faryon93/vocore2-mb/README.md

# VoCore2 Motherboard

* 1x Ethernet Breakout
* 3x Mini-PCIe Slot (USB Connection via USB 2.0 Hub)
* MicroSD Card
* FTDI console UART
* Passive PoE or Phoenix-style connector for power
* Buzzer
* SPI Flash Breakout Header

## Board
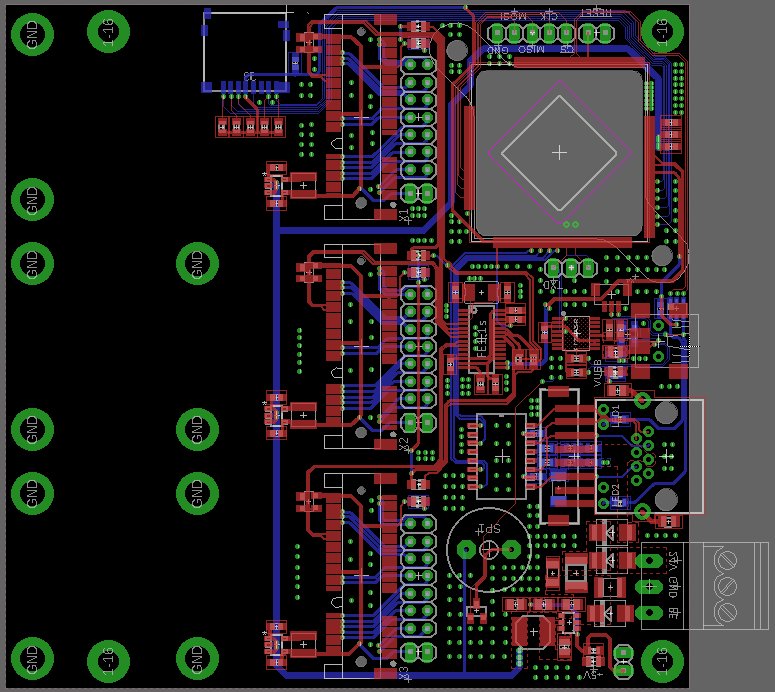
[picture p1: pcb-screenshot.PNG]
Screenshot PCB
