faryon93/vocore2-mb/vocore2-motherboard.brd

## EAGLE design vocore2-motherboard.brd (2019-12-21)

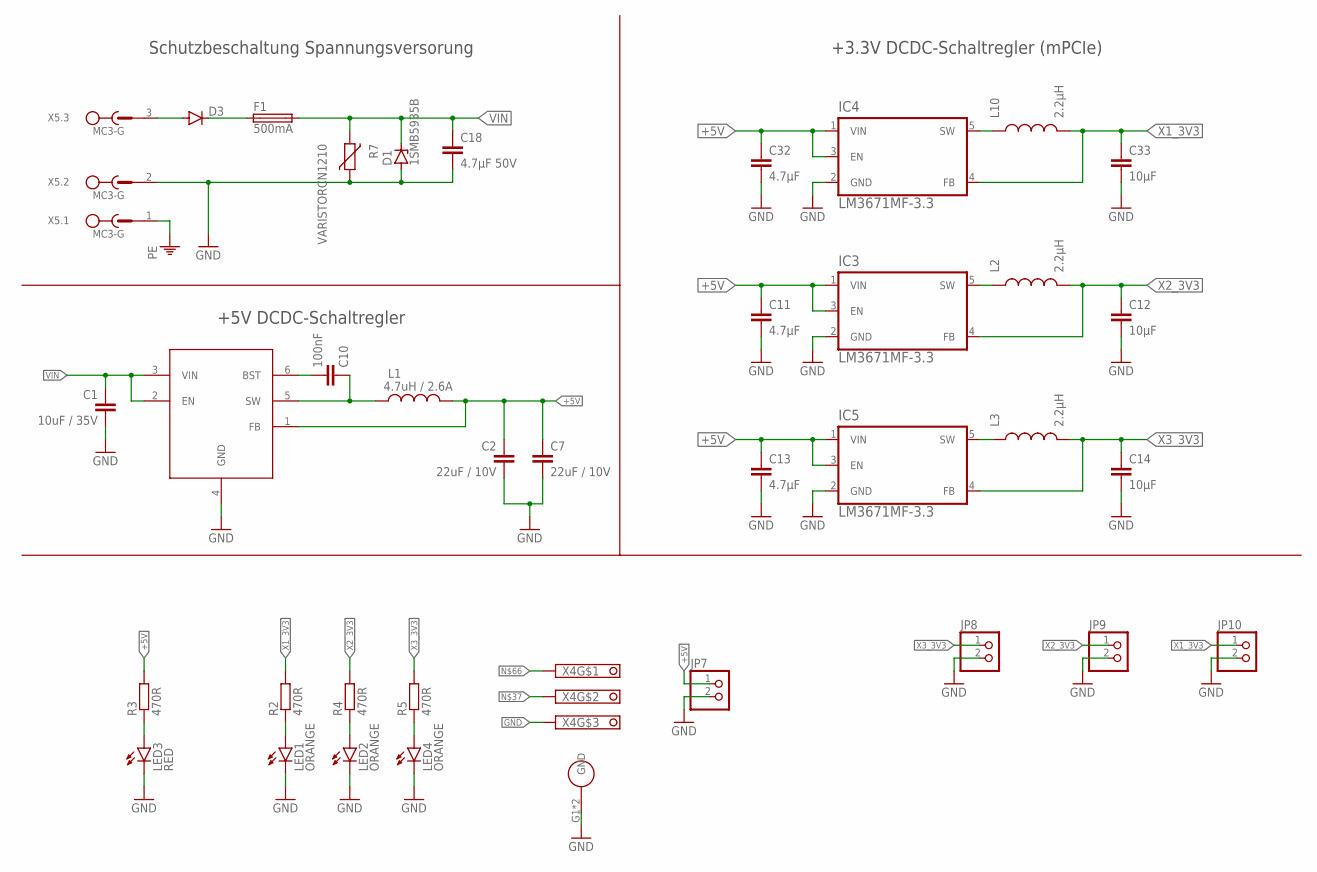
[picture p2: schematic vocore2-motherboard.sch, sheet 1, Power]

Parts:
C1: 10uF / 35V; C0805; DIGIKEY 490-13248-1-ND
C2, C7: 22uF / 10V; C0805; DIGIKEY 490-10511-1-ND
C10: 100nF; C0805
C11, C13, C32: 4.7µF; C0603; DIGIKEY 1276-2087-1-ND
C12, C14, C33: 10µF; C0603
C18: 4.7µF 50V; C1206; DIGIKEY 587-2994-1-ND
D1: 1SMB5935B; SMB; FARNELL 1431177
D3: DIODE-SMB; SMB; FARNELL 1858651
F1: 500mA; 1812; LCSC C17313
IC1: AP63205; SOT23-6
IC3, IC4, IC5: LM3671MF-3.3; SOT95P284X122-5N; DIGIKEY LM3671MF-3.3/NOPBCT-ND
JP7: PINHD-1X2_2.54; 1X02
JP8, JP9, JP10: PINHD-1X2; 1X02
L1: 4.7uH / 2.6A; 4.90X4.90; DIGIKEY 587-3605-2-ND
L2, L3, L10: 2.2µH; SO3314; DIGIKEY 445-8725-1-ND
LED1, LED2, LED4: ORANGE; CHIP-LED0805; DIGIKEY 160-1445-1-ND
LED3: RED; CHIP-LED0805; DIGIKEY 160-1447-1-ND
R2, R3, R4, R5: 470R; R0603
R7: VARISTORCN1210; CT/CN1210; FARNELL 1636457
X4: BM03B-SRSS-TB
X5: MC3-G; DIGIKEY ‎277-1207-ND‎;‎277-13872-ND‎

Connections:
+5V: C2.1, C7.1, C11.1, C13.1, C32.1, IC1.1 (FB), IC3.1 (VIN), IC3.3 (EN), IC4.1 (VIN), IC4.3 (EN), IC5.1 (VIN), IC5.3 (EN), JP7.1, L1.P$2 (2), R3.2; also elsewhere on the board
+24V: D3.C, F1.1; also elsewhere on the board
GND: C1.2, C2.2, C7.2, C11.2, C12.2, C13.2, C14.2, C18.2, C32.2, C33.2, D1.A, IC1.4 (GND), IC3.2 (GND), IC4.2 (GND), IC5.2 (GND), JP7.2, JP8.2, JP9.2, JP10.2, LED1.C, LED2.C, LED3.C, LED4.C, R7.1, X4.3 (K), X4.G1 (GND), X4.G2 (GND), X5.2; also elsewhere on the board
unnamed: C10.1, IC1.5 (SW), L1.P$1 (1)
unnamed: IC3.5 (SW), L2.1
unnamed: IC5.5 (SW), L3.1
unnamed: LED3.A, R3.1
unnamed: LED1.A, R2.1
unnamed: LED2.A, R4.1
unnamed: LED4.A, R5.1
unnamed 43: X4.2 (K); also elsewhere on the board
unnamed: IC4.5 (SW), L10.1
unnamed: D3.A, X5.3
unnamed: C10.2, IC1.6 (BST)
unnamed 65: X4.1 (K); also elsewhere on the board
PE: X5.1
VIN: C1.1, C18.1, D1.C, F1.2, IC1.2 (EN), IC1.3 (VIN), R7.2
X1_3V3: C33.1, IC4.4 (FB), JP10.1, L10.2, R2.2; also elsewhere on the board
X2_3V3: C12.1, IC3.4 (FB), JP9.1, L2.2, R4.2; also elsewhere on the board
X3_3V3: C14.1, IC5.4 (FB), JP8.1, L3.2, R5.2; also elsewhere on the board

Notes on the sheet:
Schutzbeschaltung Spannungsversorung
+5V DCDC-Schaltregler
+3.3V DCDC-Schaltregler (mPCIe)

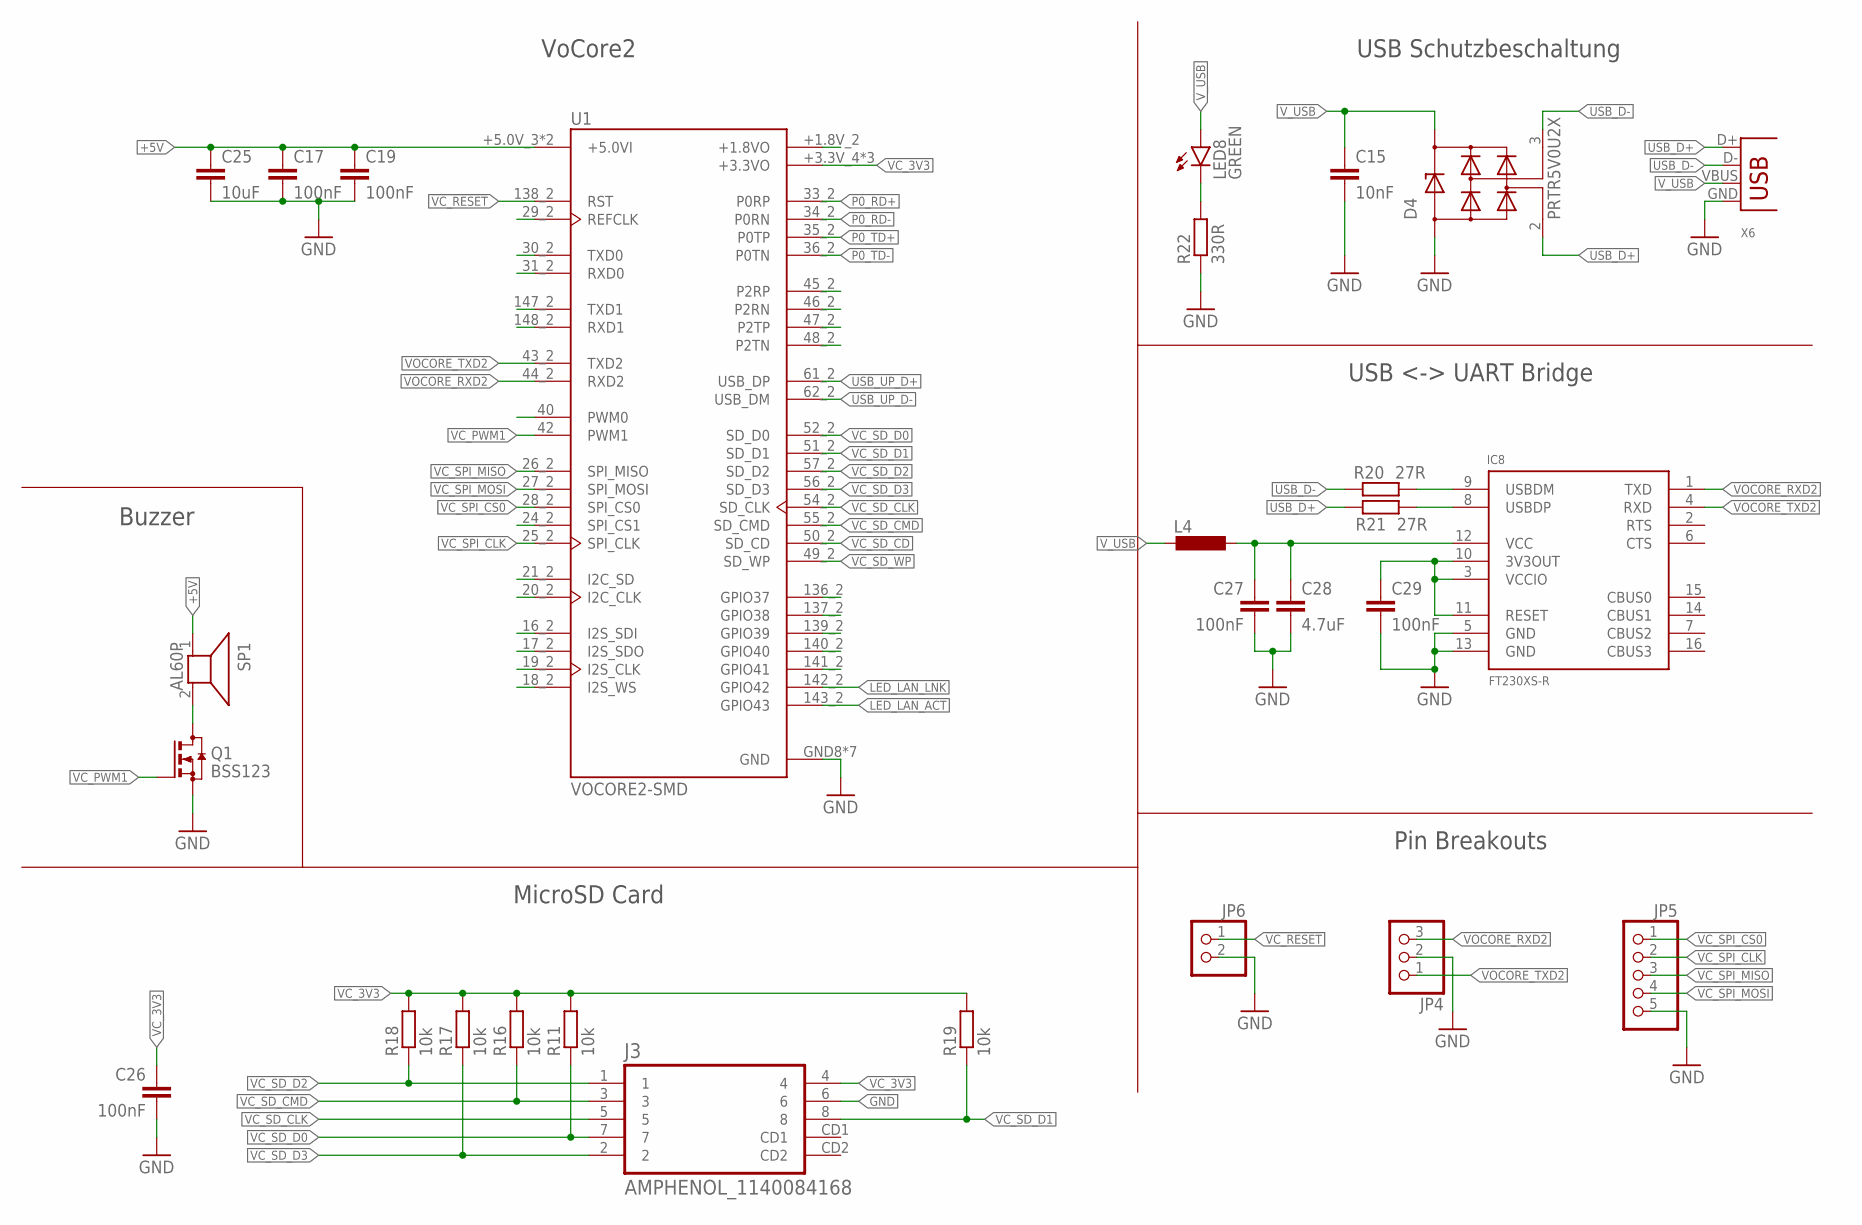
[picture p3: schematic vocore2-motherboard.sch, sheet 2, VoCore & UART Bridge]

Parts:
C15: 10nF; C0603
C17, C19, C26, C27, C29: 100nF; C0603
C25: 10uF; C0603
C28: 4.7uF; C0603
D4: PRTR5V0U2X; SOT143; DIGIKEY 1727-3884-1-ND
IC8: FT230XS-R; SSOP16-0.635-5X4MM
J3: AMPHENOL_1140084168
JP4: PINHD-1X3; 1X03
JP5: PINHD-1X5; 1X05
JP6: PINHD-1X2_2.54; 1X02
L4: L-EUL0805; L0805; DIGIKEY 490-1054-1-ND
LED8: GREEN; CHIP-LED0805; DIGIKEY 160-1446-1-ND
Q1: BSS123; SOT23; DIGIKEY BSS123LT1GOSCT-ND‎
R11, R16, R17, R18, R19: 10k; R0603
R20, R21: 27R; R0603
R22: 330R; R0603
SP1: AL60P; LCSC C252917
U1: VOCORE2-SMD; VOCORE2_SMD
X6: USB-MB-S

Connections:
!VC_RESET: JP6.1, U1.138_2 (RST)
+5V: C17.1, C19.1, C25.1, SP1.1, U1.+5.0V_3 (+5.0VI), U1.+5.0V_4 (+5.0VI); also elsewhere on the board
FT230_VCCIO: C29.1, IC8.3 (VCCIO), IC8.10 (3V3OUT), IC8.11 (RESET)
GND: C15.2, C17.2, C19.2, C25.2, C26.2, C27.2, C28.2, C29.2, D4.1 (GND), IC8.5 (GND), IC8.13 (GND), J3.6, JP4.2, JP5.5, JP6.2, Q1.2 (S), R22.1, U1.GND8 (GND), U1.GND9 (GND), U1.GND10 (GND), U1.GND11 (GND), U1.GND12 (GND), U1.GND13 (GND), U1.GND14 (GND), X6.GND; also elsewhere on the board
LED_LAN_ACT: U1.143_2 (GPIO43); also elsewhere on the board
LED_LAN_LNK: U1.142_2 (GPIO42); also elsewhere on the board
unnamed: Q1.3 (D), SP1.2
unnamed: C27.1, C28.1, IC8.12 (VCC), L4.1
unnamed: IC8.9 (USBDM), R20.2
unnamed: IC8.8 (USBDP), R21.1
unnamed: LED8.C, R22.2
P0_RD+: U1.33_2 (P0RP); also elsewhere on the board
P0_RD-: U1.34_2 (P0RN); also elsewhere on the board
P0_TD+: U1.35_2 (P0TP); also elsewhere on the board
P0_TD-: U1.36_2 (P0TN); also elsewhere on the board
USB_D+: D4.2 (IO1), R21.2, X6.D+
USB_D-: D4.3 (IO2), R20.1, X6.D-
USB_UP_D+: U1.61_2 (USB_DP); also elsewhere on the board
USB_UP_D-: U1.62_2 (USB_DM); also elsewhere on the board
VC_3V3: C26.1, J3.4, R11.2, R16.2, R17.2, R18.2, R19.2, U1.+3.3V_4 (+3.3VO), U1.+3.3V_5 (+3.3VO), U1.+3.3V_6 (+3.3VO); also elsewhere on the board
VC_PWM1: Q1.1 (G), U1.42 (PWM1)
VC_SD_CD: U1.50_2 (SD_CD)
VC_SD_CLK: J3.5, U1.54_2 (SD_CLK)
VC_SD_CMD: J3.3, R16.1, U1.55_2 (SD_CMD)
VC_SD_D0: J3.7, R11.1, U1.52_2 (SD_D0)
VC_SD_D1: J3.8, R19.1, U1.51_2 (SD_D1)
VC_SD_D2: J3.1, R18.1, U1.57_2 (SD_D2)
VC_SD_D3: J3.2, R17.1, U1.56_2 (SD_D3)
VC_SD_WP: U1.49_2 (SD_WP)
VC_SPI_CLK: JP5.2, U1.25_2 (SPI_CLK)
VC_SPI_CS0: JP5.1, U1.28_2 (SPI_CS0)
VC_SPI_MISO: JP5.3, U1.26_2 (SPI_MISO)
VC_SPI_MOSI: JP5.4, U1.27_2 (SPI_MOSI)
VOCORE_RXD2: IC8.1 (TXD), JP4.3, U1.44_2 (RXD2)
VOCORE_TXD2: IC8.4 (RXD), JP4.1, U1.43_2 (TXD2)
V_USB: C15.1, D4.4 (VCC), L4.2, LED8.A, X6.VBUS

Notes on the sheet:
USB Schutzbeschaltung
Pin Breakouts
USB <-> UART Bridge
VoCore2
MicroSD Card
Buzzer

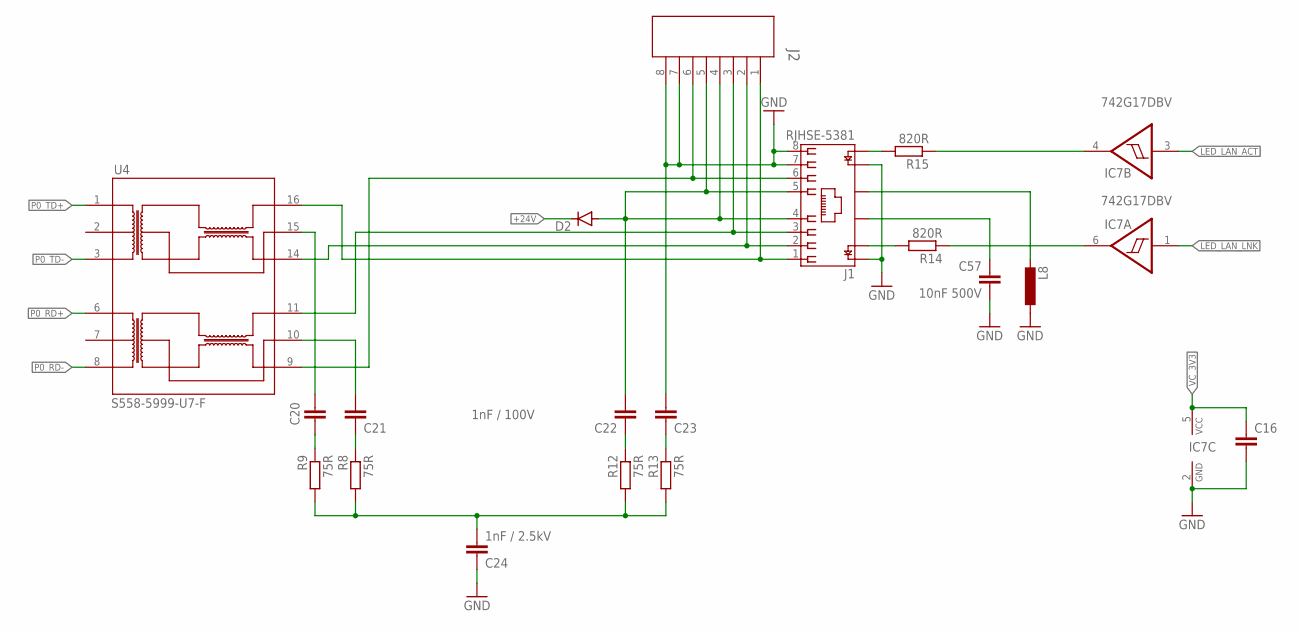
[picture p4: schematic vocore2-motherboard.sch, sheet 3, Ethernet & POE]

Parts:
C16: 100nF; C0603; DIGIKEY 490-4780-1-ND
C20, C21, C22, C23: 1nF / 100V; C0603; DIGIKEY 490-4780-1-ND
C24: 1nF / 2.5kV; C1808; DIGIKEY 399-7246-1-ND
C57: 10nF 500V; C0805; DIGIKEY 709-1021-1-ND
D2: DIODE-SMB; SMB; FARNELL 1858651
IC7: 742G17DBV; DBV_R-PDSO-G6; DIGIKEY 296-13010-1-ND
J1: RJHSE-5381; AMPHENOL_RJHSE-5381
J2: TE_1775470-8; CONN8_1775470-8; DIGIKEY A100058CT-ND
L8: L-EUL0805; L0805; DIGIKEY 490-1054-1-ND
R8, R9, R12, R13: 75R; R0603; DIGIKEY RNCP0603FTD75R0CT-ND‎
R14, R15: 820R; R0603; DIGIKEY A129687CT-ND
U4: S558-5999-U7-F

Connections:
+24V: D2.C; also elsewhere on the board
GND: C16.2, C23.2, C24.1, C57.2, IC7.2 (GND), J1.7, J1.8, J1.9, J1.11, J2.7, J2.8, L8.1; also elsewhere on the board
LED_LAN_ACT: IC7.3 (I); also elsewhere on the board
LED_LAN_LNK: IC7.1 (I); also elsewhere on the board
unnamed: C20.2, U4.15 (TX_CT)
unnamed: C21.2, U4.10 (RX_CT)
unnamed: C21.1, R8.1
unnamed: C20.1, R9.1
unnamed: C22.1, R12.1
unnamed: C23.1, R13.1
unnamed: C24.2, R8.2, R9.2, R12.2, R13.2
unnamed 43: IC7.4 (O), R15.1; also elsewhere on the board
unnamed: J1.12, R15.2
unnamed: J1.10, R14.2
unnamed: J1.S2, L8.2
unnamed: C57.1, J1.S1
unnamed 65: IC7.6 (O), R14.1; also elsewhere on the board
P0_RD+: U4.6 (RD+); also elsewhere on the board
P0_RD-: U4.8 (RD-); also elsewhere on the board
P0_TD+: U4.1 (TD+); also elsewhere on the board
P0_TD-: U4.3 (TD-); also elsewhere on the board
POE_V+: C22.2, D2.A, J1.4, J1.5, J2.4, J2.5
RX+: J1.3, J2.3, U4.11 (RX+)
RX-: J1.6, J2.6, U4.9 (RX-)
TX+: J1.1, J2.1, U4.16 (TX+)
TX-: J1.2, J2.2, U4.14 (TX-)
VC_3V3: C16.1, IC7.5 (VCC); also elsewhere on the board

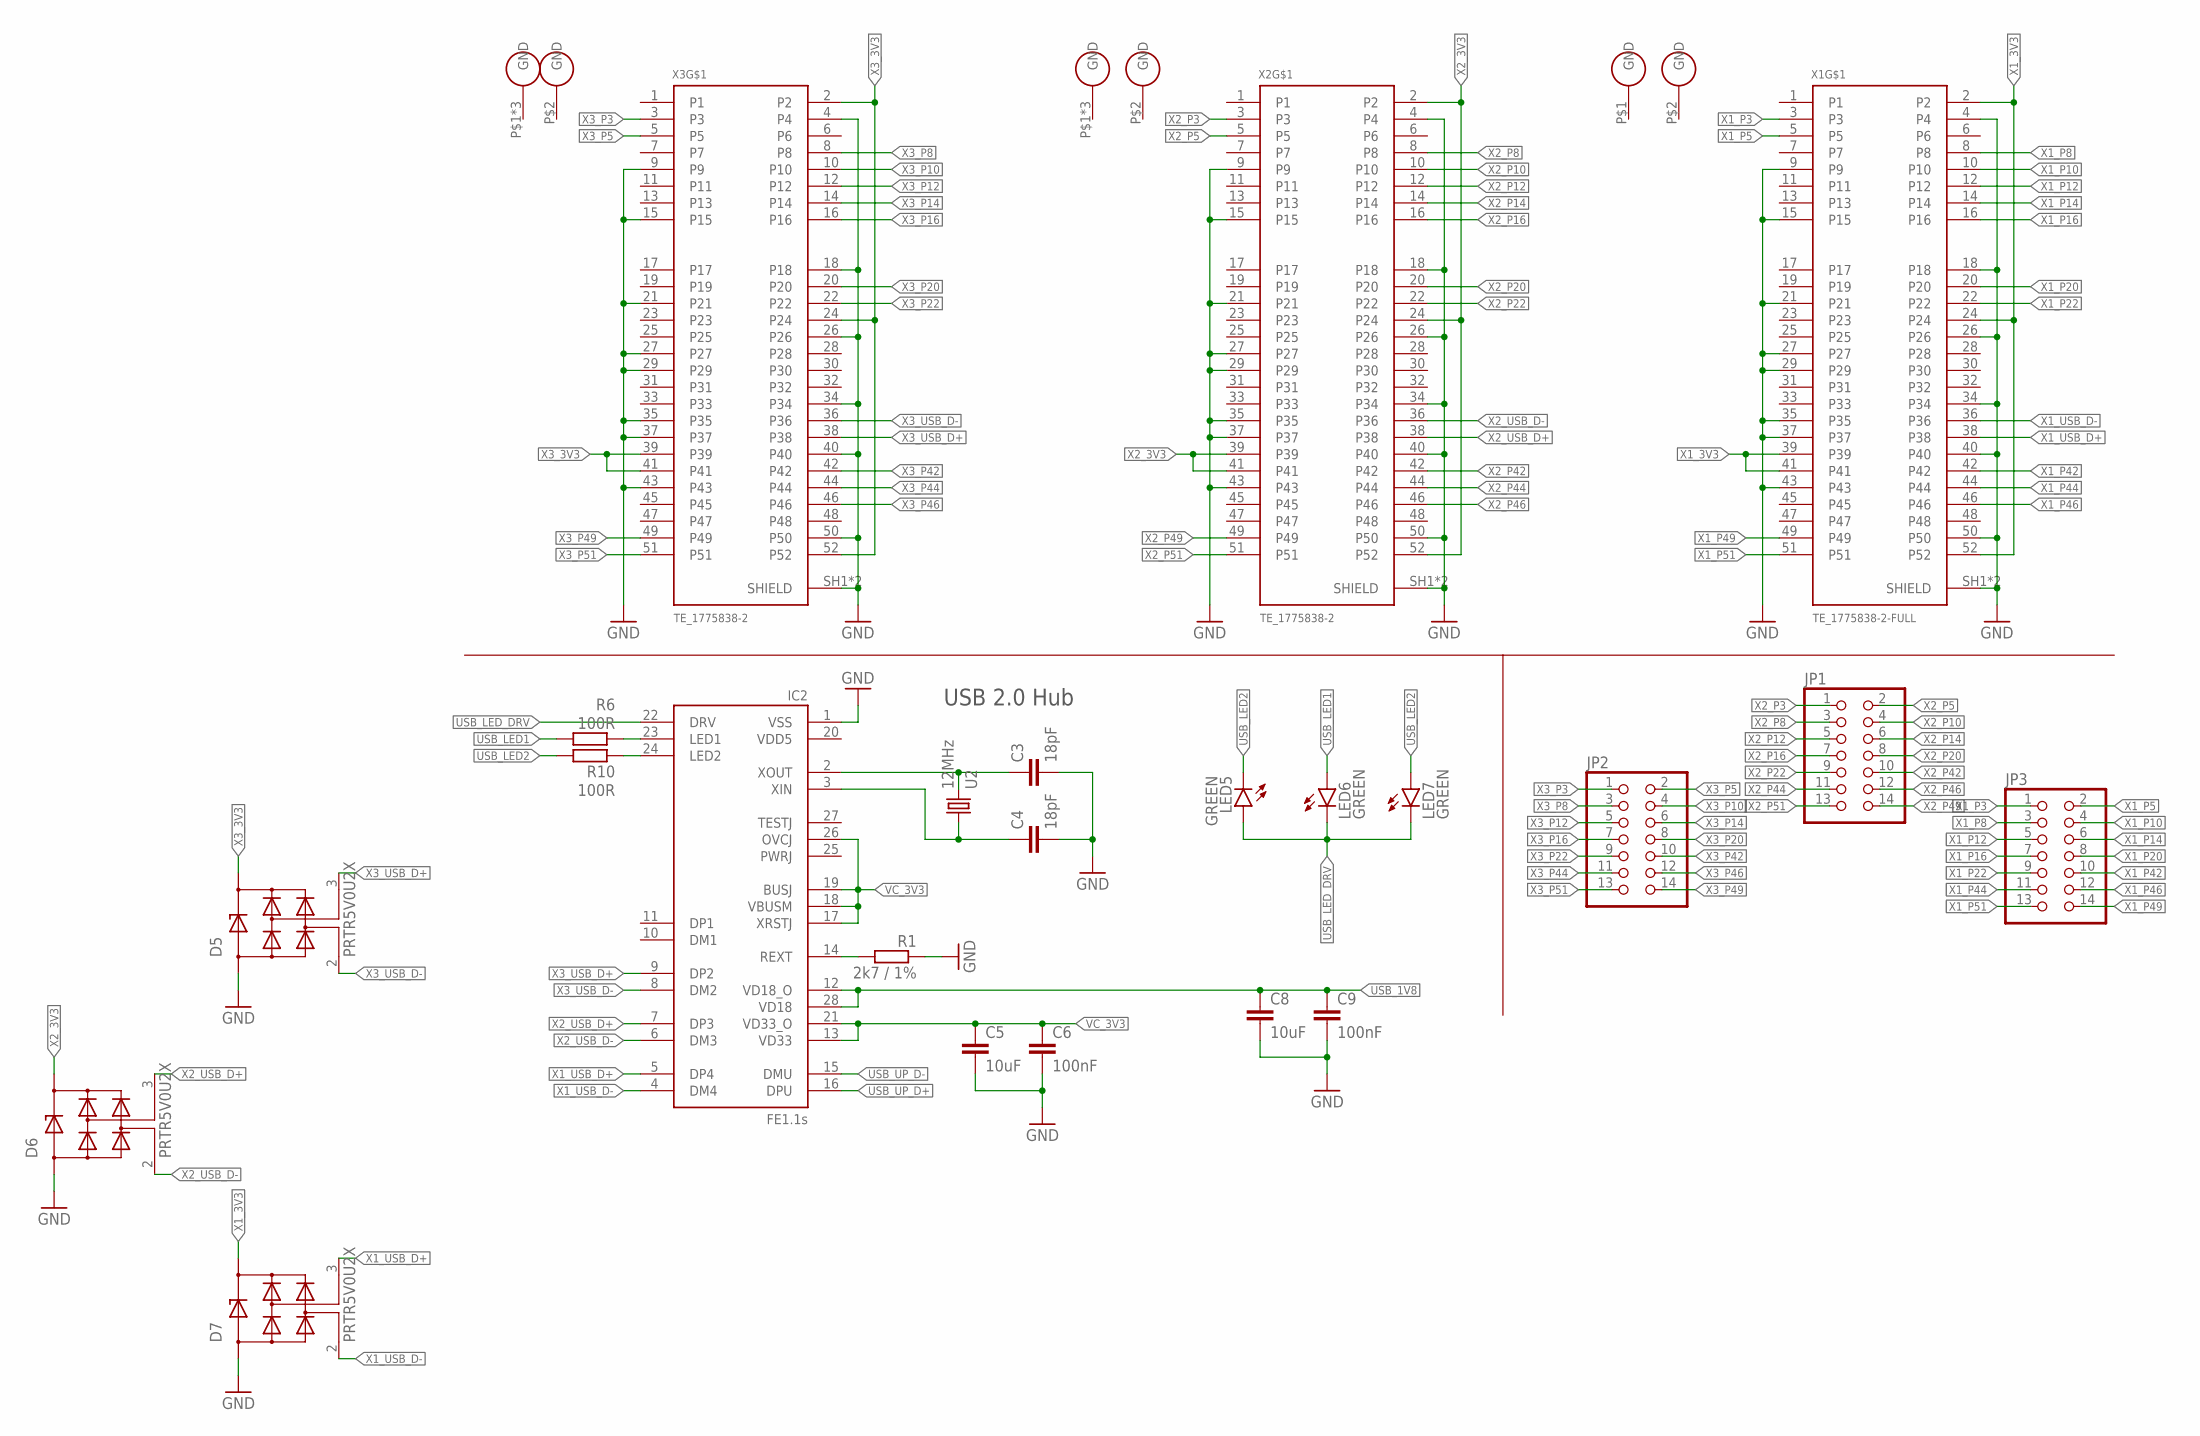
[picture p5: schematic vocore2-motherboard.sch, sheet 4, Mini-PCIe & USB-Hub]

Parts:
C3, C4: 18pF; C0603
C5, C8: 10uF; C0603
C6, C9: 100nF; C0603
D5, D6, D7: PRTR5V0U2X; SOT143; DIGIKEY 1727-3884-1-ND
IC2: FE1.1S; FE1.1S_SSOP-28
JP1, JP2, JP3: PINHD-2X7; 2X07
LED5, LED6, LED7: GREEN; CHIP-LED0805; DIGIKEY 160-1446-1-ND
R1: 2k7 / 1%; R0603; DIGIKEY RR08P2.7KDCT-ND
R6, R10: 100R; R0603
U2: 12MHz; 7A; FARNELL 1841940
X1: TE_1775838-2-FULL
X2, X3: TE_1775838-2

Connections:
GND: C3.2, C4.2, C5.2, C6.2, C8.2, C9.2, D5.1 (GND), D6.1 (GND), D7.1 (GND), IC2.1 (VSS), R1.1, X1.4, X1.9, X1.15, X1.18, X1.21, X1.26, X1.27, X1.29, X1.34, X1.35, X1.37, X1.40, X1.43, X1.50, X1.P$1 (GND), X1.P$2 (GND), X1.SH1 (SHIELD), X1.SH2 (SHIELD), X2.4, X2.9, X2.15, X2.18, X2.21, X2.26, X2.27, X2.29, X2.34, X2.35, X2.37, X2.40, X2.43, X2.50, X2.P$1 (GND), X2.P$2 (GND), X2.P$3 (GND), X2.P$4 (GND), X2.SH1 (SHIELD), X2.SH2 (SHIELD), X3.4, X3.9, X3.15, X3.18, X3.21, X3.26, X3.27, X3.29, X3.34, X3.35, X3.37, X3.40, X3.43, X3.50, X3.P$1 (GND), X3.P$2 (GND), X3.P$3 (GND), X3.P$4 (GND), X3.SH1 (SHIELD), X3.SH2 (SHIELD); also elsewhere on the board
unnamed: C3.1, IC2.2 (XOUT), U2.2
unnamed: C4.1, IC2.3 (XIN), U2.1
unnamed: IC2.14 (REXT), R1.2
unnamed: IC2.23 (LED1), R6.1
unnamed: IC2.24 (LED2), R10.1
USB_1V8: C8.1, C9.1, IC2.12 (VD18_O), IC2.28 (VD18)
USB_LED1: LED6.A, R6.2
USB_LED2: LED5.C, LED7.A, R10.2
USB_LED_DRV: IC2.22 (DRV), LED5.A, LED6.C, LED7.C
USB_UP_D+: IC2.16 (DPU); also elsewhere on the board
USB_UP_D-: IC2.15 (DMU); also elsewhere on the board
VC_3V3: C5.1, C6.1, IC2.13 (VD33), IC2.17 (XRSTJ), IC2.18 (VBUSM), IC2.19 (BUSJ), IC2.21 (VD33_O), IC2.26 (OVCJ); also elsewhere on the board
X1_3V3: D7.4 (VCC), X1.2, X1.24, X1.39, X1.41, X1.52; also elsewhere on the board
X1_P3: JP3.1, X1.3
X1_P5: JP3.2, X1.5
X1_P8: JP3.3, X1.8
X1_P10: JP3.4, X1.10
X1_P12: JP3.5, X1.12
X1_P14: JP3.6, X1.14
X1_P16: JP3.7, X1.16
X1_P20: JP3.8, X1.20
X1_P22: JP3.9, X1.22
X1_P42: JP3.10, X1.42
X1_P44: JP3.11, X1.44
X1_P46: JP3.12, X1.46
X1_P49: JP3.14, X1.49
X1_P51: JP3.13, X1.51
X1_USB_D+: D7.3 (IO2), IC2.5 (DP4), X1.38
X1_USB_D-: D7.2 (IO1), IC2.4 (DM4), X1.36
X2_3V3: D6.4 (VCC), X2.2, X2.24, X2.39, X2.41, X2.52; also elsewhere on the board
X2_P3: JP1.1, X2.3
X2_P5: JP1.2, X2.5
X2_P8: JP1.3, X2.8
X2_P10: JP1.4, X2.10
X2_P12: JP1.5, X2.12
X2_P14: JP1.6, X2.14
X2_P16: JP1.7, X2.16
X2_P20: JP1.8, X2.20
X2_P22: JP1.9, X2.22
X2_P42: JP1.10, X2.42
X2_P44: JP1.11, X2.44
X2_P46: JP1.12, X2.46
X2_P49: JP1.14, X2.49
X2_P51: JP1.13, X2.51
X2_USB_D+: D6.3 (IO2), IC2.7 (DP3), X2.38
X2_USB_D-: D6.2 (IO1), IC2.6 (DM3), X2.36
X3_3V3: D5.4 (VCC), X3.2, X3.24, X3.39, X3.41, X3.52; also elsewhere on the board
X3_P3: JP2.1, X3.3
X3_P5: JP2.2, X3.5
X3_P8: JP2.3, X3.8
X3_P10: JP2.4, X3.10
X3_P12: JP2.5, X3.12
X3_P14: JP2.6, X3.14
X3_P16: JP2.7, X3.16
X3_P20: JP2.8, X3.20
X3_P22: JP2.9, X3.22
X3_P42: JP2.10, X3.42
X3_P44: JP2.11, X3.44
X3_P46: JP2.12, X3.46
X3_P49: JP2.14, X3.49
X3_P51: JP2.13, X3.51
X3_USB_D+: D5.3 (IO2), IC2.9 (DP2), X3.38
X3_USB_D-: D5.2 (IO1), IC2.8 (DM2), X3.36

Notes on the sheet:
USB 2.0 Hub

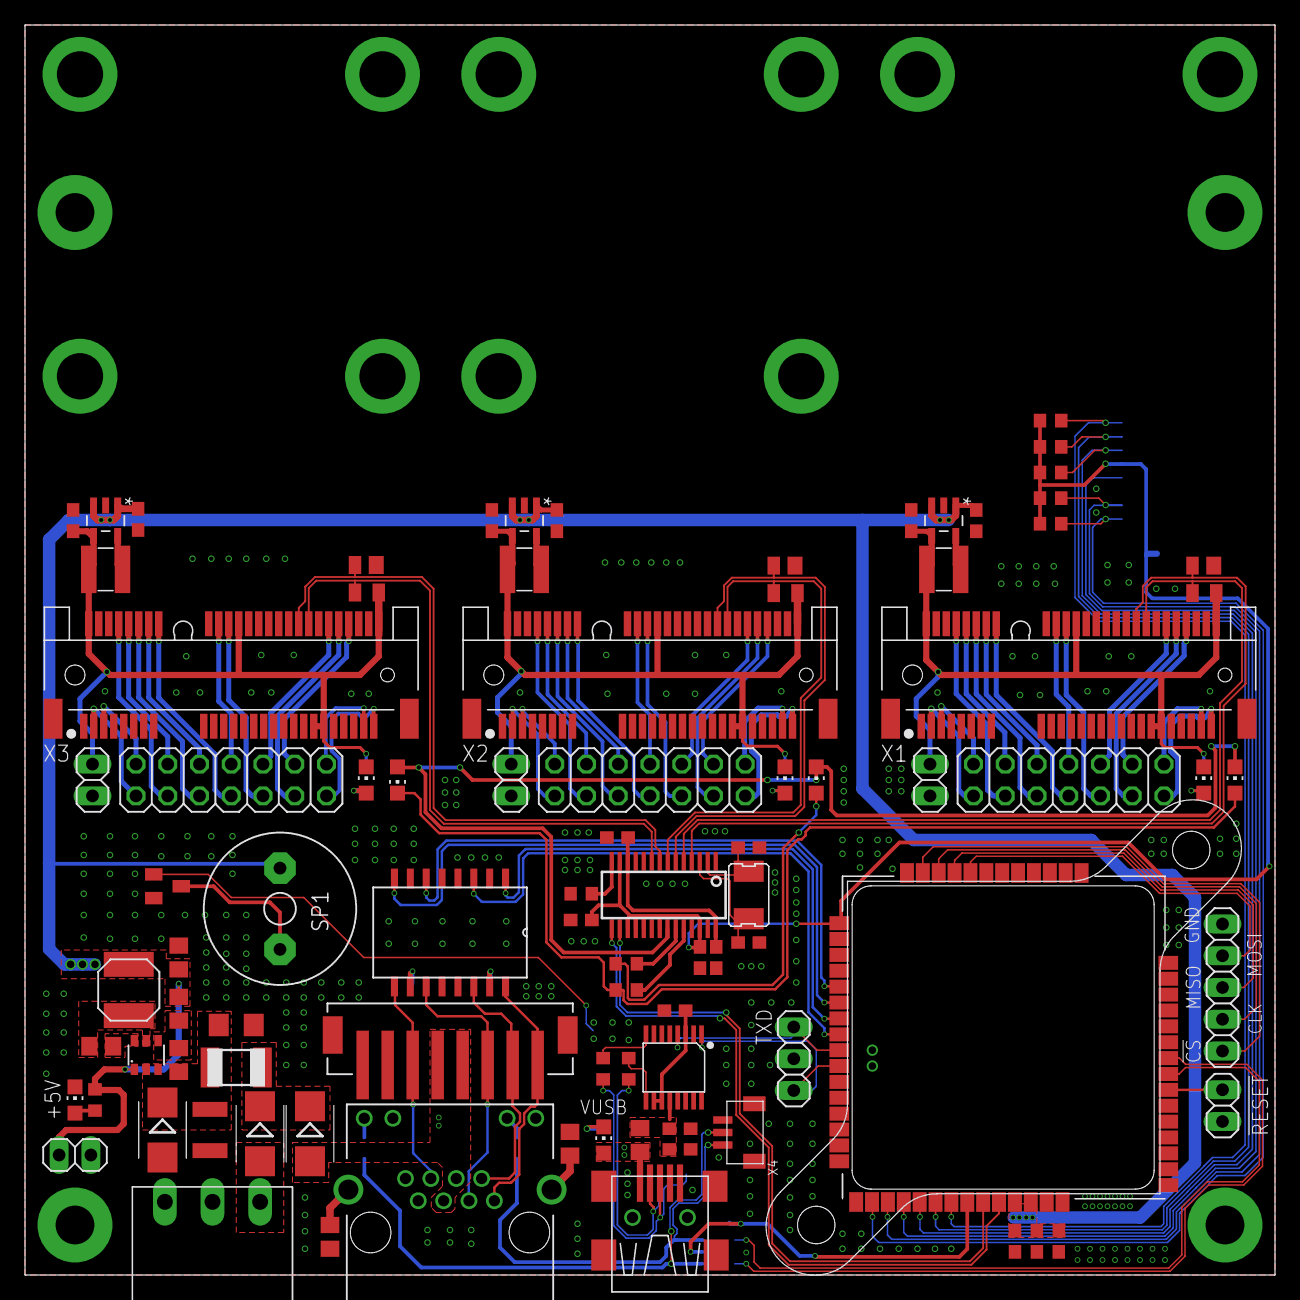
[picture p6: board vocore2-motherboard.brd from above]

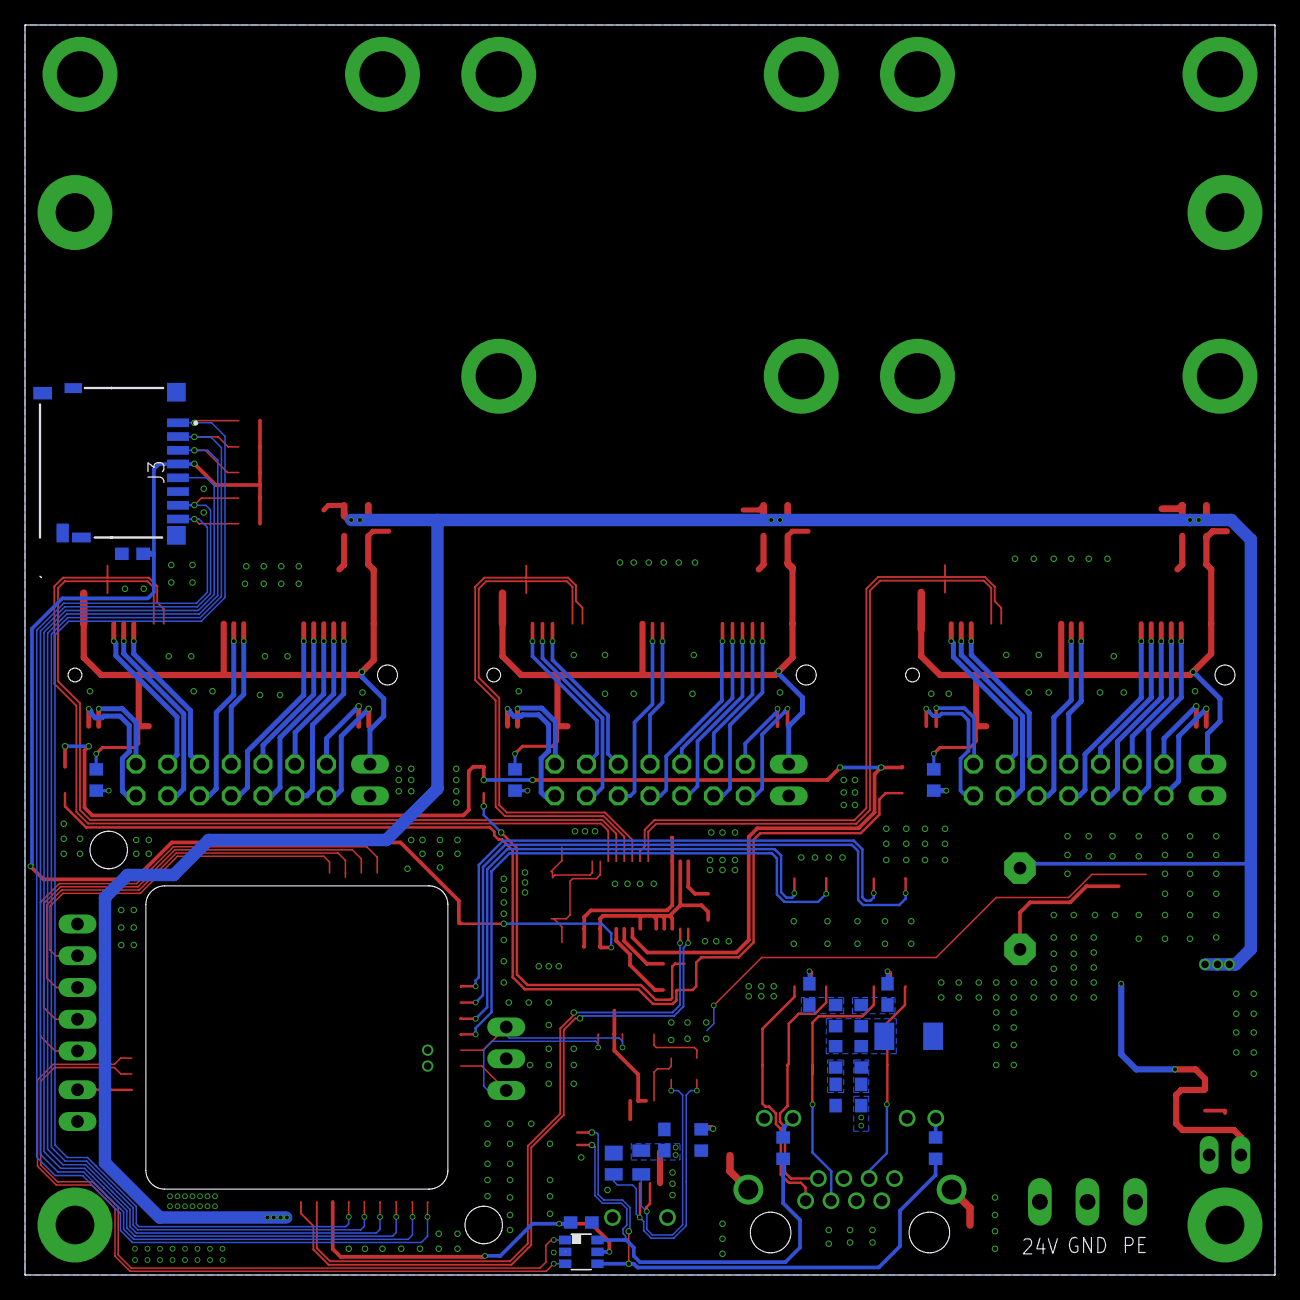
[picture p7: board vocore2-motherboard.brd from below]

Board: 2 copper layers, 100.0 x 100.0 mm, 108 parts (21 on the bottom side), 124 nets.

Other parts of the board:
U$1: ATS-P1-138-C2-R0
