faryon93/vocore2-mb/(commit log)

2019-11-04 fix: moved LAN_LED_ACT to gpio43
    gpio43 can be configured to represent the LNK/ACT state of the Ethernt
    PHYs Port 0.
    [vocore2-motherboard.brd, vocore2-motherboard.sch]
2019-11-04 fix: typo in partname LM3761MF -> LM3671MF
    [vocore2-motherboard.brd, vocore2-motherboard.sch]
2019-11-04 feat: added digikey part numbers
    [vocore2-motherboard.brd, vocore2-motherboard.sch]
2019-11-04 fix: proper colors for leds
    PWR = red
    MPCIE_PWR = orange
    MPCIE_USB = green
    [vocore2-motherboard.brd, vocore2-motherboard.sch]
2019-11-04 fix: corrected led restistor values
    [vocore2-motherboard.brd, vocore2-motherboard.sch]
2019-11-04 fix: some more digikey part numbers
    [vocore2-motherboard.brd, vocore2-motherboard.sch]
2019-11-04 refactor: new symbol for ethernet transformer U4
    [vocore2-motherboard.brd, vocore2-motherboard.sch]
2019-11-04 fix: switched SD_D0 and SD_D1
    [vocore2-motherboard.brd, vocore2-motherboard.sch]
2019-11-12 fix(p0led): use inverting-buffer to drive lan leds
    [vocore2-motherboard.brd, vocore2-motherboard.sch]
2019-11-12 feat(sch): cleanup page 3 vocore & uart bridge
    [vocore2-motherboard.sch]
2019-11-12 feat: use FT230X instead of FT232R
    [vocore2-motherboard.brd, vocore2-motherboard.sch]
2019-11-12 feat(pcb): mounting hole for vocore
    [vocore2-motherboard.brd, vocore2-motherboard.sch]
2019-11-12 fix(brd): proper heatsink dimensions
    [vocore2-motherboard.brd, vocore2-motherboard.sch]
2019-11-12 feat: LED für V_USB
    [vocore2-motherboard.brd, vocore2-motherboard.sch]
2019-11-12 feat(brd): threaded inserts for PCIe half-sized card (X3 and X2 only)
    [vocore2-motherboard.brd, vocore2-motherboard.sch]
2019-11-12 fix: changed led resistor values
    [vocore2-motherboard.brd, vocore2-motherboard.sch]
2019-11-13 fix(pcb): reconnected buzzer
    [vocore2-motherboard.brd, vocore2-motherboard.sch]
2019-11-13 feat: 3V3 + GND pinheader for each minipcie-slot
    [vocore2-motherboard.brd, vocore2-motherboard.sch]
2019-11-13 fix: use non-inverting buffers to drive lan leds
    The rt3050 ethernet switch, integrated on the SoC, has the ability to
    configure led polarity. Therefore it is not necessary to fix the
    active-low problem in hardware.
    [vocore2-motherboard.brd, vocore2-motherboard.sch]
2019-11-13 feat(pcb): skylabs SKW92A outline
    [vocore2-motherboard.brd]
2019-11-13 feat(pcb): Beschriftung Phoenix Stromstecker
    [vocore2-motherboard.brd]
2019-11-14 feat: TVS diodes on MiniPCIe slots
    [vocore2-motherboard.brd, vocore2-motherboard.sch]
2019-11-16 feat: network led breakout
    [vocore2-motherboard.brd, vocore2-motherboard.sch]
2019-12-21 feat(pcb): removed through-hole mounts for vocore2
    [vocore2-motherboard.brd, vocore2-motherboard.sch]
2019-12-21 fix: tPlace outline for all ICs
    [vocore2-motherboard.brd, vocore2-motherboard.sch]
2019-12-21 feat(readme): added basic readme with pcb screenshot
2019-12-21 fix(readme): rotated pcb screenshot
